cibomahto/leery-lisn/pcb/lisn-pcb/lisn-pcb.kicad_pcb

## KiCad design pcb/lisn-pcb/lisn-pcb.kicad_pcb (2024-12-20)

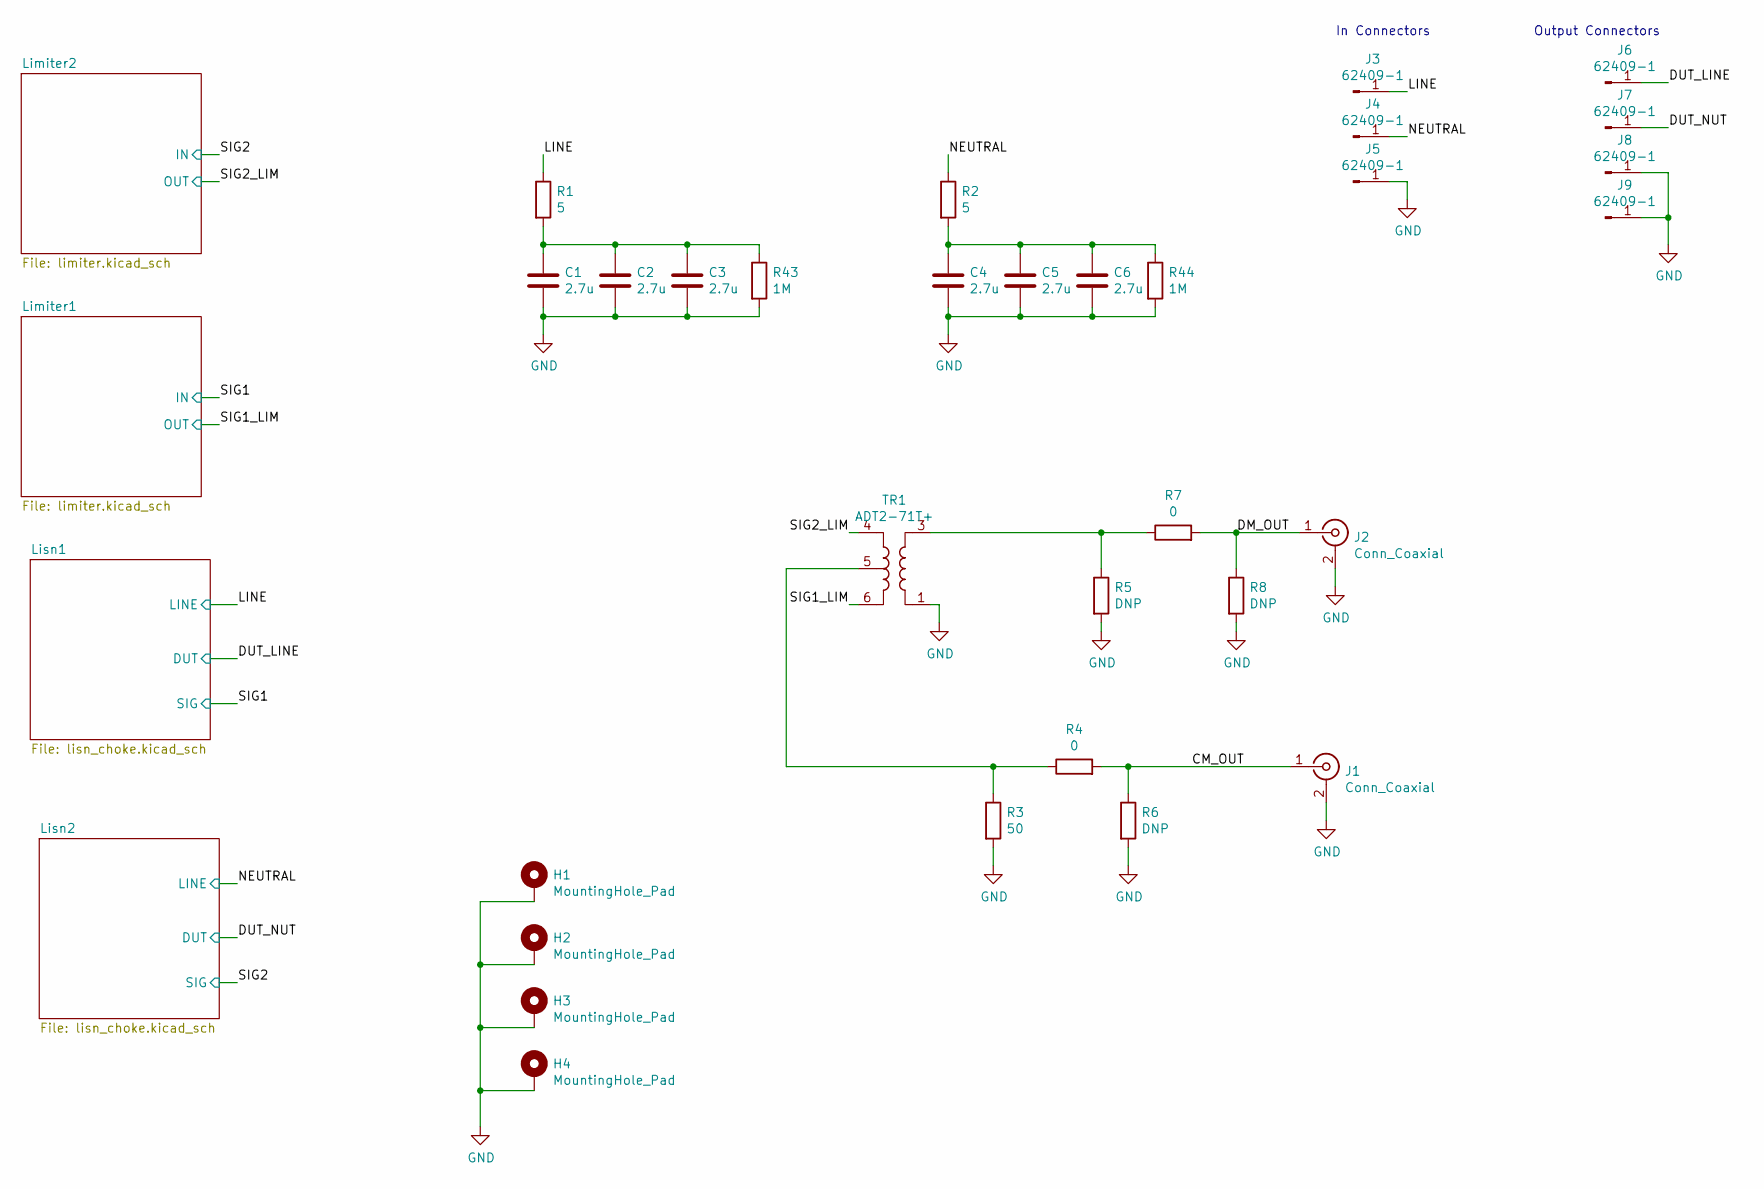
[picture p1: schematic lisn-pcb.kicad_sch]

Parts:
C1, C2, C3, C4, C5, C6: 2.7u; C_Rect_L31.5mm_W20.0mm_P27.50mm_MKS4; MPN ECQ-UAAF275K
H1, H2, H3, H4: MountingHole_Pad; M3-tight-fit-socket-head
J1, J2: Conn_Coaxial; SMA_Amphenol_132203-12_Horizontal; MPN 619540-1
J3, J4, J5, J6, J7, J8, J9: 62409-1; MPN 62409-1
R1, R2: 5; R_Axial_Power_L20.0mm_W6.4mm_P25.40mm; MPN WNE5R0FET
R3: 50; R_0805_2012Metric; MPN RNCP0805FTD49R9
R4, R7: 0; R_0805_2012Metric; MPN RC0805JR-070RL
R5, R6, R8: DNP; R_0805_2012Metric
R43, R44: 1M; R_Axial_DIN0414_L11.9mm_D4.5mm_P15.24mm_Horizontal; MPN ROX1SJ1M0
TR1: ADT2-71T+; Mini-Circuits_CD637_H5.23mm; MPN ADT2-71T+

Connections:
/CM_OUT: J1.1 (In), R4.2, R6.1
/DM_OUT: J2.1 (In), R7.2, R8.1
/DUT_LINE: J6.1; also elsewhere on the board
/DUT_NUT: J7.1; also elsewhere on the board
/LINE: J3.1, R1.1; also elsewhere on the board
/NEUTRAL: J4.1, R2.1; also elsewhere on the board
/SIG1_LIM: TR1.6; also elsewhere on the board
/SIG2_LIM: TR1.4; also elsewhere on the board
GND: C1.2, C2.2, C3.2, C4.2, C5.2, C6.2, H1.1, H2.1, H3.1, H4.1, J1.2 (Ext), J2.2 (Ext), J5.1, J8.1, J9.1, R3.2, R5.2, R6.2, R8.2, R43.2, R44.2, TR1.1; also elsewhere on the board
unnamed: C1.1, C2.1, C3.1, R1.2, R43.1
unnamed: C4.1, C5.1, C6.1, R2.2, R44.1
unnamed: R3.1, R4.1, TR1.5
unnamed: R5.1, R7.1, TR1.3

Notes on the sheet:
Output Connectors
In Connectors

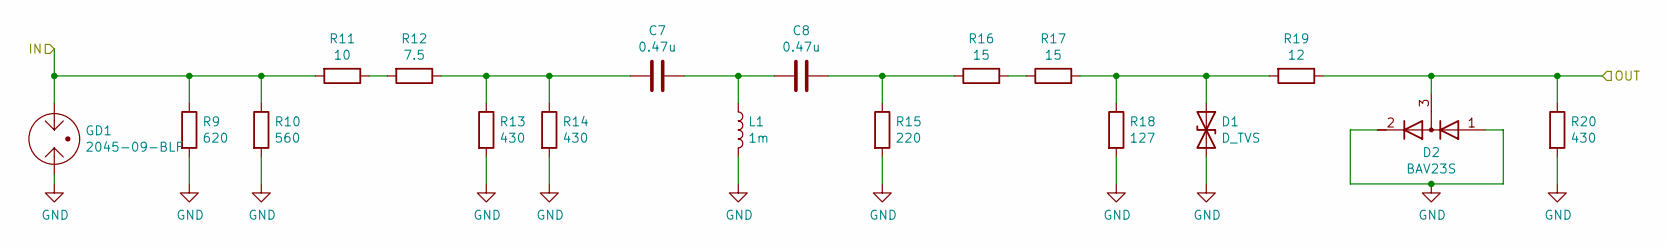
[picture p2: schematic limiter.kicad_sch]

Parts:
C7, C8: 0.47u; C_0805_2012Metric; MPN 08051C474K4Z2A
D1: D_TVS; D_SOD-323; MPN STS321050B100
D2: BAV23S; SOT-23; MPN BAV23S,215
GD1: 2045-09-BLF; GDT_Bourns_2045; MPN 2045-09-BLF
L1: 1m; L_BOURNS_PM1812; MPN PM1812-102J-RC
R9: 620; R_0805_2012Metric; MPN RCS0805620RFKEA
R10: 560; R_0805_2012Metric; MPN RCS0805560RFKEA
R11: 10; R_0805_2012Metric; MPN RCS080510R0FKEA
R12: 7.5; R_0805_2012Metric; MPN RCS08057R50FKEA
R13, R14, R20: 430; R_0805_2012Metric; MPN ESR10EZPF4300
R15: 220; R_0805_2012Metric; MPN RCS0805220RFKEA
R16, R17: 15; R_0805_2012Metric; MPN RCS080515R0FKEA
R18: 127; R_0805_2012Metric; MPN RK73H2ATTD1270F
R19: 12; R_0805_2012Metric; MPN ERJ-6ENF12R0V

Connections:
/SIG1: GD1.1, R9.1, R10.1, R11.2; also elsewhere on the board
/SIG1_LIM: D2.3 (common), R19.1, R20.1; also elsewhere on the board
GND: D1.2 (A2), D2.1 (A), D2.2 (K), GD1.2, L1.2, R9.2, R10.2, R13.2, R14.2, R15.2, R18.2, R20.2; also elsewhere on the board
unnamed: C7.1, C8.2, L1.1
unnamed: C7.2, R12.1, R13.1, R14.1
unnamed: C8.1, R15.1, R16.1
unnamed: D1.1 (A1), R17.2, R18.1, R19.2
unnamed: R11.1, R12.2
unnamed: R16.2, R17.1

Parts of its further copies:
C10, C11: 0.47u; C_0805_2012Metric; MPN 08051C474K4Z2A
D3: D_TVS; D_SOD-323; MPN STS321050B100
D4: BAV23S; SOT-23; MPN BAV23S,215
GD2: 2045-09-BLF; GDT_Bourns_2045; MPN 2045-09-BLF
L7: 1m; L_BOURNS_PM1812; MPN PM1812-102J-RC
R26: 620; R_0805_2012Metric; MPN RCS0805620RFKEA
R27: 560; R_0805_2012Metric; MPN RCS0805560RFKEA
R28: 10; R_0805_2012Metric; MPN RCS080510R0FKEA
R29: 7.5; R_0805_2012Metric; MPN RCS08057R50FKEA
R30, R31, R37: 430; R_0805_2012Metric; MPN ESR10EZPF4300
R32: 220; R_0805_2012Metric; MPN RCS0805220RFKEA
R33, R34: 15; R_0805_2012Metric; MPN RCS080515R0FKEA
R35: 127; R_0805_2012Metric; MPN RK73H2ATTD1270F
R36: 12; R_0805_2012Metric; MPN ERJ-6ENF12R0V

Connections of its further copies:
/SIG2: GD2.1, R26.1, R27.1, R28.2; also elsewhere on the board
/SIG2_LIM: D4.3 (common), R36.1, R37.1; also elsewhere on the board
GND: D3.2 (A2), D4.1 (A), D4.2 (K), GD2.2, L7.2, R26.2, R27.2, R30.2, R31.2, R32.2, R35.2, R37.2; also elsewhere on the board
unnamed: C10.1, C11.2, L7.1
unnamed: C10.2, R29.1, R30.1, R31.1
unnamed: C11.1, R32.1, R33.1
unnamed: D3.1 (A1), R34.2, R35.1, R36.2
unnamed: R28.1, R29.2
unnamed: R33.2, R34.1

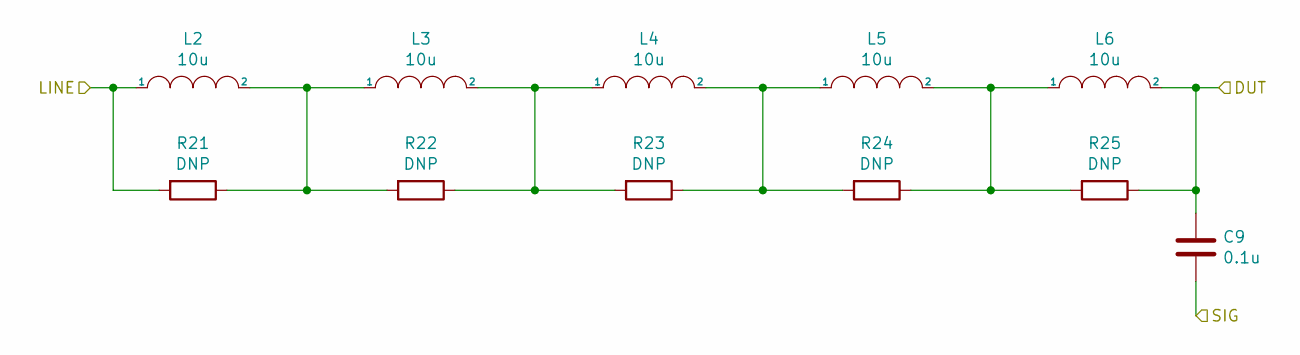
[picture p3: schematic lisn_choke.kicad_sch]

Parts:
C9: 0.1u; C_Rect_L26.5mm_W10.5mm_P22.50mm_MKS4; MPN BFC233860104
L2, L3, L4, L5, L6: 10u; L_WURTH_WE-HCC-1090; MPN 7443331000
R21, R22, R23, R24, R25: DNP; R_1206_3216Metric

Connections:
/DUT_LINE: C9.1, L6.2, R25.1; also elsewhere on the board
/LINE: L2.1, R21.2; also elsewhere on the board
/SIG1: C9.2; also elsewhere on the board
unnamed: L2.2, L3.1, R21.1, R22.2
unnamed: L3.2, L4.1, R22.1, R23.2
unnamed: L4.2, L5.1, R23.1, R24.2
unnamed: L5.2, L6.1, R24.1, R25.2

Parts of its further copies:
C12: 0.1u; C_Rect_L26.5mm_W10.5mm_P22.50mm_MKS4; MPN BFC233860104
L8, L9, L10, L11, L12: 10u; L_WURTH_WE-HCC-1090; MPN 7443331000
R38, R39, R40, R41, R42: DNP; R_1206_3216Metric

Connections of its further copies:
/DUT_NUT: C12.1, L12.2, R42.1; also elsewhere on the board
/NEUTRAL: L8.1, R38.2; also elsewhere on the board
/SIG2: C12.2; also elsewhere on the board
unnamed: L8.2, L9.1, R38.1, R39.2
unnamed: L9.2, L10.1, R39.1, R40.2
unnamed: L10.2, L11.1, R40.1, R41.2
unnamed: L11.2, L12.1, R41.1, R42.2

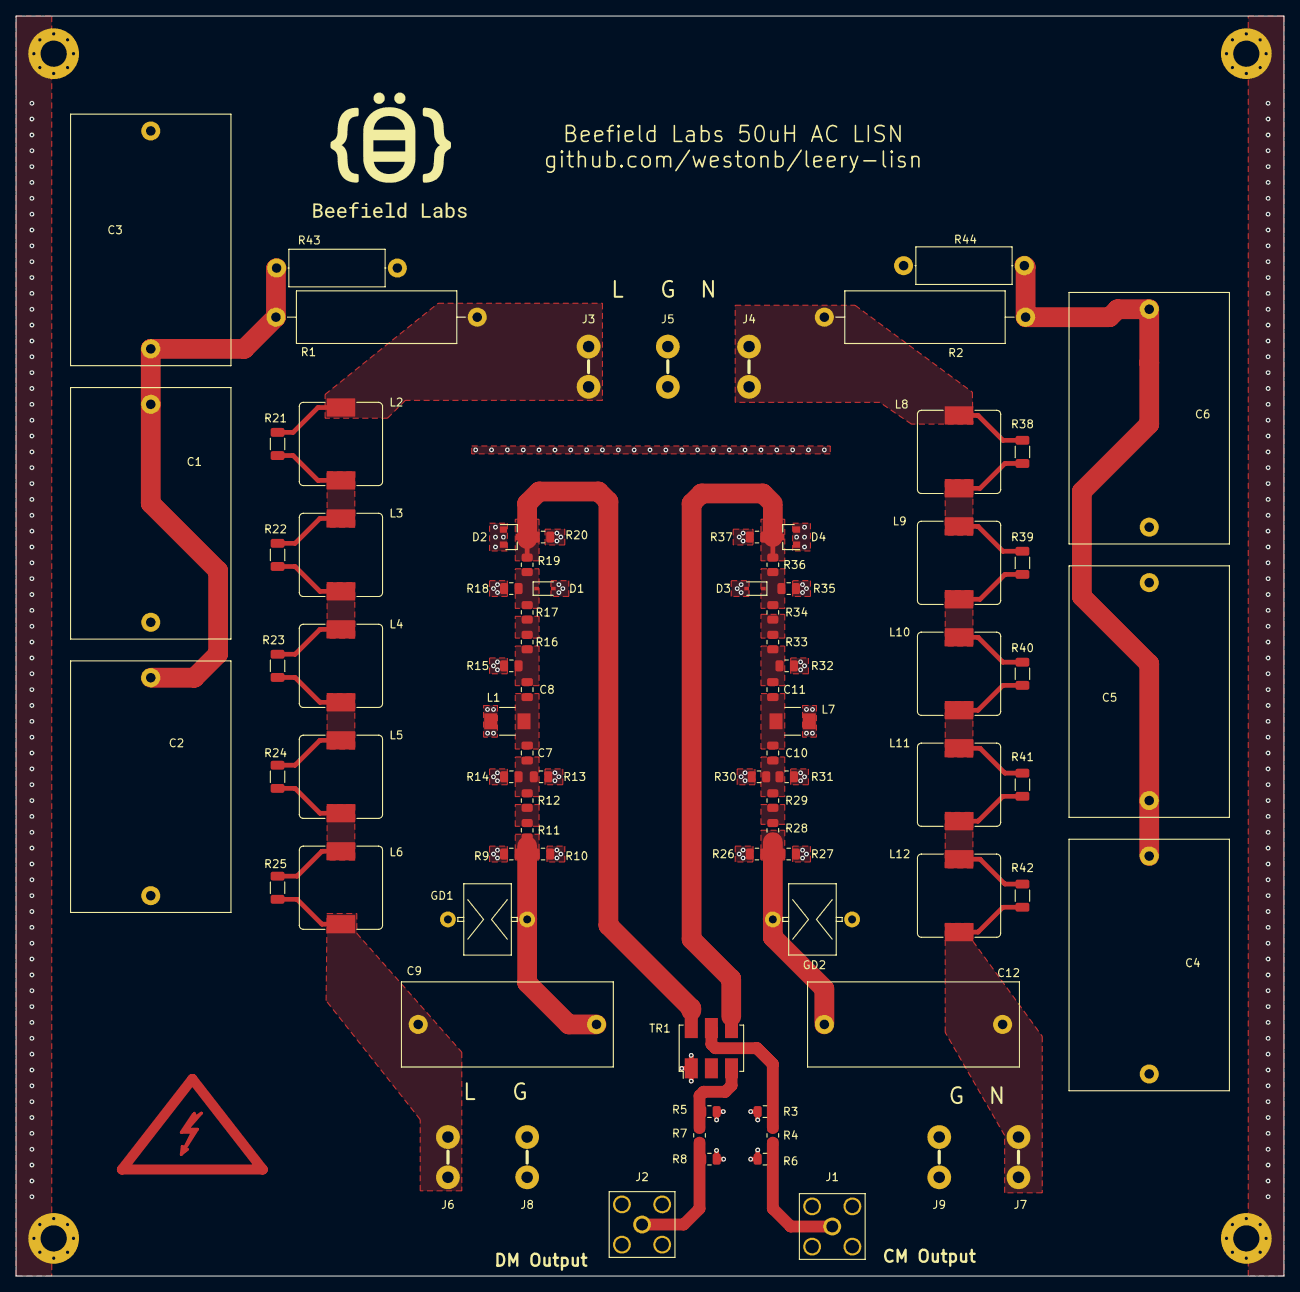
[picture p4: board lisn-pcb.kicad_pcb from above]

Board: 2 copper layers, 160.0 x 159.0 mm, 88 parts (0 on the bottom side), 35 nets.
