cibomahto/leery-lisn/(commit log)

2024-12-04 Bump to KiCad 8, add BOM info
    [front-panel.kicad_pcb, front-panel.kicad_sch, limiter.kicad_sch, lisn-pcb.kicad_pcb, lisn-pcb.kicad_sch, lisn_choke.kicad_sch]
2024-12-10 Add bleed resistors
    [lisn-pcb-B_Cu.gbr, lisn-pcb-B_Mask.gbr, lisn-pcb-B_Paste.gbr, lisn-pcb-B_Silkscreen.gbr, lisn-pcb-Edge_Cuts.gbr, lisn-pcb-F_Cu.gbr, lisn-pcb-F_Mask.gbr, lisn-pcb-F_Paste.gbr]
2024-12-20 Use a larger value for the bleed resistors
    [lisn-pcb.kicad_pcb, lisn-pcb.kicad_sch]
